shen111-6/ajf-01-adjustable-fixture/docs/design-report.md

# AJF-01：矩形工件可调定位夹具——设计项目报告

## 项目定位与完成边界
面向桌面尺寸检查、轻型装配时的矩形工件定位。已交付 SolidWorks 原生实体零件、29实例装配、28个有效锁定配合（另1个旧旋钮配合已抑制）、6张关联视图工程图，以及独立二维标注图、BOM和计算脚本。模型由AI辅助通过SolidWorks API生成，应由使用者打开、复核并完成亲自修改后，作为能解释的个人设计项目展示。尚无加工实物、重复定位实测、有限元结果或真实生产使用记录。模型里的锁定配合表示夹紧姿态，不是可拖动的运动模型。

## 需求与坐标
设计工件长度L=25～100mm、宽度W=20～80mm、高度H=10～20mm，质量不超过1kg；样例60×60×20mm。底板220×160×12mm。坐标X沿开口、Y沿夹爪、Z沿底板厚度；坐标原点为底板左下角底面。SW前视基准面对应XY，默认等轴测截图因此显得竖立，安装使用时底板水平。

## 方案与定位
选用“固定侧面+端挡块+滑动夹爪+手动推杆+双M8锁紧”，比较普通虎钳（现成但难体现自主结构选择）、T形槽压板（上方遮挡）、本方案（结构简单，方便展示定位面）。A为底板上表面，限制Z平移及绕X/Y转动；B为固定夹爪右侧面X=40，限制X平移及绕Z转动；C为端挡块后侧面Y=30，限制Y平移。这里是连续平面近似3-2-1定位思想，未设计六个离散定位点。推杆沿X作用于活动夹爪，工件靠紧B/C；两颗M8螺栓在槽中锁紧活动夹爪。向上拔出工件的约束只来自摩擦，不能按有正向Z夹紧能力使用，也不作为切削加工或吊装夹具。

## 结构与尺寸对应
固定夹爪置于(20,20,12)，其M6孔与底板(30,40)/(30,120)对齐。活动夹爪样例位置(100,20,12)，M8中心(110,40)/(110,120)。两条槽的端圆中心X=65/165，Y=40/120，宽9，总长109。端挡块置于(40,20,12)，M6中心(50,25)；其左面靠固定夹爪限制自身转动。支架置于(185,60,12)，M6中心(195,68)/(195,102)，M10孔轴线Y=85、Z=32。150mm推杆样例从X=120至270，旋钮覆盖丝杆末端12mm（X=258～270），形成连接啮合。底板下有15mm支脚，M8锁紧螺栓端部至Z=-11，距支承平面Z=-15尚有4mm名义间隙。

原95mm推杆不能覆盖小开口，已改为150mm全螺纹推杆。原方案20mm最小开口会让夹爪与端挡块仅零间隙，考虑公差后改为25mm最小开口；此时名义间隙5mm。25～100mm时活动夹爪M8中心X=L+50=75～150，距离槽中心端点分别至少10/15mm。推杆尾部与旋钮随开口变化，最大X约310mm；使用区域应留出伸出空间。两颗锁紧螺栓采用M8×65：54mm的上垫圈顶高减65mm杆长得到末端-11mm，避免长度选择不当碰桌面。

## 计算与敏感性
计算见calculations.csv/json及calculations.json及evidence记录。以T=KFd估算推杆轴向力，仅作为初步选型，未建立丝杆螺旋副与端面摩擦精确模型。推杆输入0.6N·m，K=0.15～0.25、d=10mm，轴向力约240～400N。取400N进行夹爪局部弯曲估算。将夹爪局部等效为宽20、厚20、高40mm悬臂，E假设206000MPa：I=13333.33mm⁴，σ=12MPa，δ≈0.00311mm。实际接触分布、孔洞、连接柔度、局部应力及螺栓力矩未包含，不能把这个数当整套夹具精度或有限元结果。

M8双锁紧的试验用估算扭矩6N·m，K=0.15～0.25，单颗预紧3000～5000N。取μ=0.1，最小抗滑600N，对400N载荷的理论裕量1.5。垫圈接触面积190.85mm²，最大平均承压约26.2MPa。M6双连接在3N·m时单颗预紧2000～3333N：取μ=0.15，最小抗滑600N、裕量1.5；若μ下降至0.1，裕量只有1.0。因此固定夹爪和支架的防滑是本版首要实测项目，油污、接触状态和扭矩系数变化会改变结论，不能据此宣称可靠承载。建议后续增加正向抗剪定位键/销，解决对摩擦的依赖。

M6×50穿过40mm夹爪后进入底板10mm。粗略取内螺纹有效剪切面积0.5π×5.35×10=84.04mm²、允许剪应力60MPa（假设），得到抗拔约5042N，对3333N的裕量约1.51。这不是标准螺纹失效认证；实际6061材料状态、攻丝质量和装配扭矩需确认，采用钢丝螺套是候选改进。全部扭矩为验证计划输入，未实测校准，不是生产装配规范。

## 图纸与工艺
CAD文件采用毫米、模型空间1:1，XY主视图配XZ/YZ视图；孔中心由坐标表定义，基准一致避免链式累积。外形±0.10、孔中心坐标±0.05是设计目标；槽宽9+0.2/0，基准A平面度0.05、夹爪接触面平面度0.03及对底面垂直度0.03为加工意图。孔的模型尺寸为螺纹底孔/通孔包络，M6和M10的完整螺纹、紧固件内六角与倒角未建模。原生SLDDRW提供模型关联视图；详细标注与制造说明在cad目录的二维图纸，二者一起使用。

底板：锯料→粗铣两面/四边→精铣A→按同一基准钻孔/铣槽→攻M6→去毛刺→测平面度。钢夹爪：正火料→粗铣→钻孔→精加工底面和接触面→检查垂直度。端挡块：铣削→钻孔→精加工接触面。支架：铣削→钻安装孔→横向钻8.5/攻M10，采用夹具保证孔轴线高度。支脚：车削/攻M6或采购。装配后靠实物调整B/C，不承诺拆装后恢复绝对位置；要稳定重复拆装定位，应增加定位销、匹配孔加工和测量方案。

## 误差分析
区分“名义位置误差”“重新装夹重复性”和“载荷变形”。M6通孔6.6对杆径6的名义单边间隙0.3mm，远大于0.03mm几何公差；因此仅标小公差不能保证固定夹爪相对底板绝对位置。重新装夹重复性取决于A/B/C表面、清洁度、工件形状、夹紧力和测量方法，理论悬臂挠度也不能替代重复定位测试。本版不宣称0.05mm或0.1mm重复定位能力。

## 验证与结果边界
文件与模型验证：原生文件和STEP已保存；重开后核查29个实例、28个MateLock、每个零件一个实体、参考路径、原生视图数量和模型包围盒；详细结果见evidence/native-validation.txt。解析和坐标检查见evidence/analytical-validation.json。25/60/100mm开口已分别建立实际静态装配；25mm和100mm使用边界尺寸工件。检查见range-validation.txt，三个装配均执行实体干涉检查，但没有建立可拖动运动仿真。全装配接触中允许存在螺纹包络干涉：M6杆径6与攻丝底孔5、M10杆径10与底孔8.5等；不宣称软件“零干涉”。已执行三种静态装配的实体干涉检查，每种各11处简化螺纹包络干涉，未发现其他实体穿透。

样机验证计划：见prototype-test-plan.md，重复装夹测X/Y各10次、检查固定夹爪/支架滑移、测量扭矩与推力、检查支脚及底部螺栓间隙；表格留空，不能填入虚构实测值。DFMEA示例见risk-review.csv，重点是夹爪滑移、螺纹损伤、夹持面划伤和误把轻型定位夹具用于切削。

## 简历与个人参与
你应先亲自打开原生文件、修改一个尺寸并更新图纸，熟悉定位约束、丝杆改长原因、锁紧力假设、公差和加工路线，再据实写AI辅助个人项目。未亲自完成的建模操作不能写“独立熟练完成”。可立即描述项目产物和你实际核对的部分，完成亲自复核后使用resume-and-interview.md里的项目版文案。不要写已实物验证、已投产、优化提升百分比、仿真通过或未经验证的精度。

## 发布版软件验收补充
旋钮由端面相接改为覆盖丝杆尾端12mm，当前样例X=258～270；25/100mm开口时尾端最远X=235/310。主装配的旧旋钮锁定配合已抑制，28个有效配合无错误。主装配与两端实际工件装配均有11处已分类螺纹包络干涉，没有其他实体穿透。三套装配经Pack and Go扁平整理，重开时29个引用均解析自发布目录。

以上是软件几何和文件完整性验收，不是载荷、重复定位或制造质量认证。局部悬臂公式不包含真实连接柔度、摩擦散差或偏心载荷相互作用；扭矩数值是未校准的试验输入。发布版本的承载与精度不作为已实测指标。
