shen111-6/ajf-01-adjustable-fixture/source/README.md

# SolidWorks API参考

这些C#文件是本项目实际软件检查、边界装配和Pack and Go的参考实现，需要Windows、SolidWorks 2024及其官方Interop程序集。不在GitHub托管Linux运行器上运行。

直接打开solidworks目录中的模型和图纸即可查看项目；不要把API参考代码当作无需SolidWorks的独立建模软件。
