shen111-6/ajf-01-adjustable-fixture/evidence/solidworks-base-drawing.png

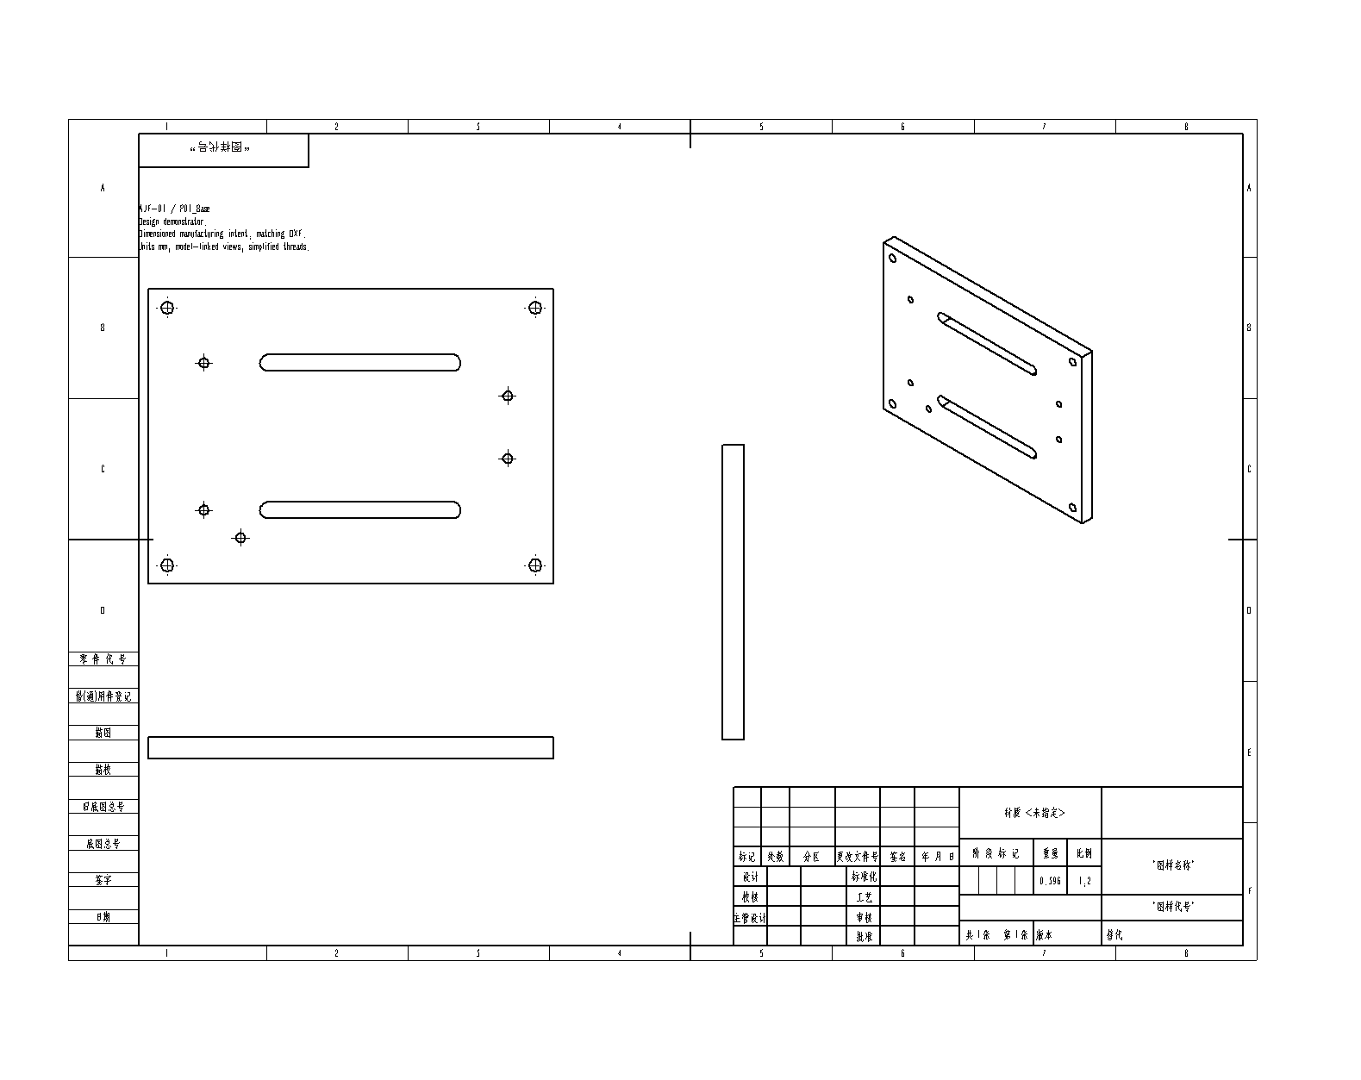
evidence/solidworks-base-drawing.png
