shen111-6/ajf-01-adjustable-fixture/evidence/solidworks-isometric.png

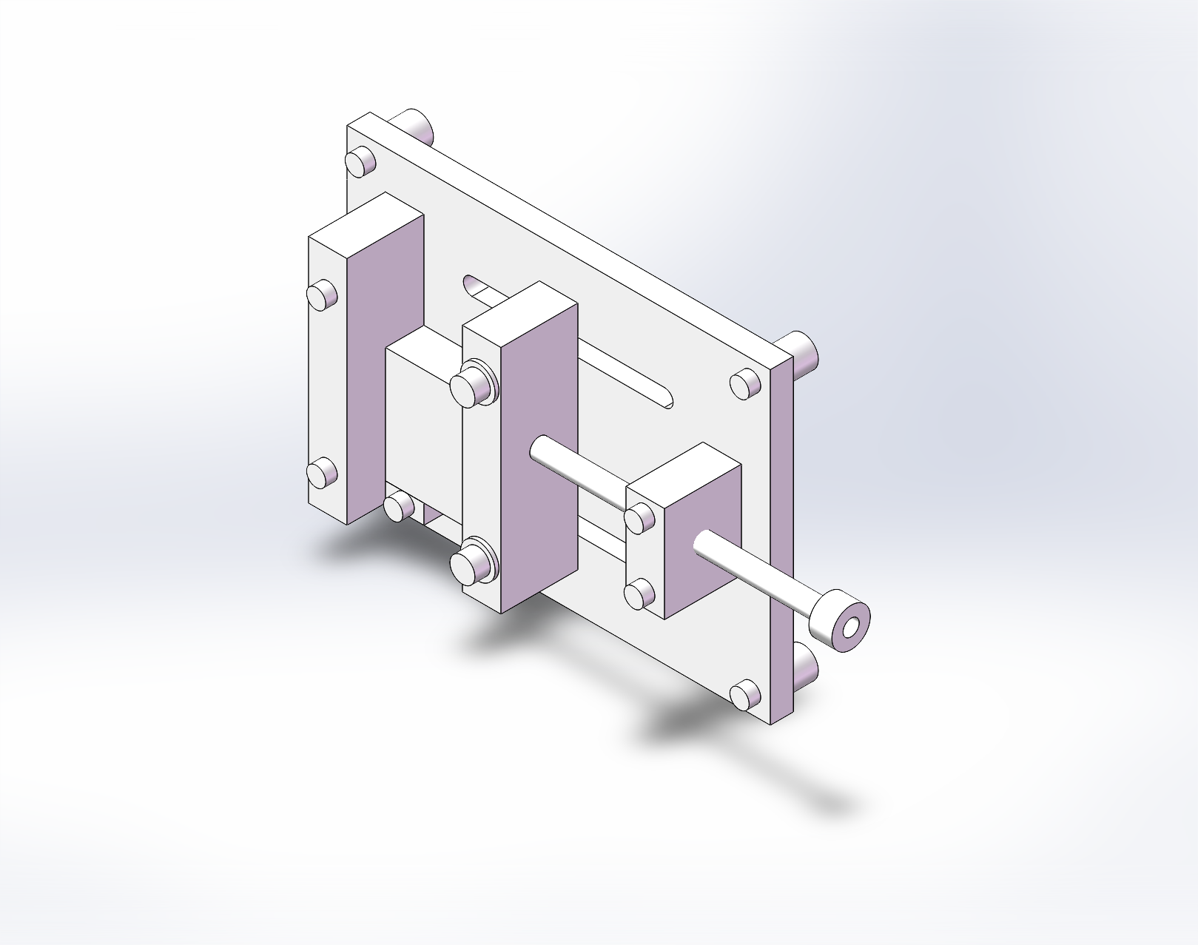
evidence/solidworks-isometric.png
