shen111-6/ajf-01-adjustable-fixture/evidence/component-transforms.txt

P02_FixedJaw-1|1,0,0,0,1,0,0,0,1,0.02,0.02,0.012,1,0,0,0
P01_Base-1|1,0,0,0,1,0,0,0,1,0,0,0,1,0,0,0
P08_Washer-3|1,0,0,0,1,0,0,0,1,0.11,0.12,0.052,1,0,0,0
P08_Washer-1|1,0,0,0,1,0,0,0,1,0.11,0.04,0.052,1,0,0,0
H04_M8Nut-2|1,0,0,0,1,0,0,0,1,0.11,0.12,-0.0085,1,0,0,0
P03_SlidingJaw-1|1,0,0,0,1,0,0,0,1,0.1,0.02,0.012,1,0,0,0
P05_ScrewBracket-1|1,0,0,0,1,0,0,0,1,0.185,0.06,0.012,1,0,0,0
P06_Spindle150-1|0,0,-1,0,1,0,1,0,0,0.12,0.085,0.032,1,0,0,0
P07_Workpiece-1|1,0,0,0,1,0,0,0,1,0.04,0.03,0.012,1,0,0,0
P08_Washer-2|1,0,0,0,1,0,0,0,1,0.11,0.04,-0.002,1,0,0,0
H04_M8Nut-1|1,0,0,0,1,0,0,0,1,0.11,0.04,-0.0085,1,0,0,0
P04_EndStop-1|1,0,0,0,1,0,0,0,1,0.04,0.02,0.012,1,0,0,0
H01_M8x65-1|1,0,0,0,1,0,0,0,1,0.11,0.04,-0.011,1,0,0,0
H02_M6x50-1|1,0,0,0,1,0,0,0,1,0.03,0.04,0.002,1,0,0,0
P08_Washer-4|1,0,0,0,1,0,0,0,1,0.11,0.12,-0.002,1,0,0,0
H01_M8x65-2|1,0,0,0,1,0,0,0,1,0.11,0.12,-0.011,1,0,0,0
H03_M6x25-4|1,0,0,0,1,0,0,0,1,0.21,0.01,-0.013,1,0,0,0
H03_M6x25-5|1,0,0,0,1,0,0,0,1,0.21,0.15,-0.013,1,0,0,0
H05_Foot-1|1,0,0,0,1,0,0,0,1,0.01,0.01,-0.015,1,0,0,0
H05_Foot-2|1,0,0,0,1,0,0,0,1,0.01,0.15,-0.015,1,0,0,0
H03_M6x25-3|1,0,0,0,1,0,0,0,1,0.01,0.15,-0.013,1,0,0,0
H02_M6x50-4|1,0,0,0,1,0,0,0,1,0.195,0.102,0.002,1,0,0,0
H02_M6x50-2|1,0,0,0,1,0,0,0,1,0.03,0.12,0.002,1,0,0,0
H03_M6x25-1|1,0,0,0,1,0,0,0,1,0.05,0.025,0.007,1,0,0,0
H05_Foot-3|1,0,0,0,1,0,0,0,1,0.21,0.01,-0.015,1,0,0,0
H02_M6x50-3|1,0,0,0,1,0,0,0,1,0.195,0.068,0.002,1,0,0,0
H03_M6x25-2|1,0,0,0,1,0,0,0,1,0.01,0.01,-0.013,1,0,0,0
H05_Foot-4|1,0,0,0,1,0,0,0,1,0.21,0.15,-0.015,1,0,0,0
H06_Knob-1|0,0,-1,0,1,0,1,0,0,0.258,0.085,0.032,1,0,0,0
