shen111-6/ajf-01-adjustable-fixture/docs/BOM.csv

编号 | 名称 | 材料/规格 | 尺寸mm | 数量 | 工艺/备注
P01 | 底板 | 6061-T6 | 220×160×12 | 1 | 铣削/钻孔/铣槽/攻M6
P02 | 固定夹爪 | 45钢 | 20×120×40 | 1 | 铣削/钻孔/精加工定位面
P03 | 活动夹爪 | 45钢 | 20×120×40 | 1 | 铣削/钻孔
P04 | 端挡块 | 45钢 | 20×10×20 | 1 | 铣削/钻孔
P05 | 丝杆支架 | 45钢 | 20×50×40 | 1 | 铣削/钻孔/攻M10
P06 | 全螺纹推杆 | 钢 | M10×1.5，杆长150 | 1 | 采购/截长/端面修整
P07 | 样例工件 | 铝 | 60×60×20 | 1 | 展示样例，不计夹具成本
P08 | 平垫圈 | 钢 | 内径9/外径18/厚2 | 4 | 采购
H01 | 锁紧螺栓 | 8.8级钢 | M8×65 | 2 | 采购；模型省略螺纹/内六角
H02 | 连接螺栓 | 8.8级钢 | M6×50 | 4 | 采购；模型省略螺纹/内六角
H03 | 短连接螺栓 | 8.8级钢 | M6×25 | 5 | 采购
H04 | 螺母 | 钢 | M8，对边13，厚6.5 | 2 | 采购
H05 | 支脚 | 钢 | 外径16，高15，M6通孔 | 4 | 采购或车削/攻丝
H06 | 手拧旋钮 | 钢/塑料 | M10连接，外径20，厚12 | 1 | 采购；需锁固至推杆，供应商确认
