shen111-6/ajf-01-adjustable-fixture/evidence/solid-interference.tsv

components | volume_mm3 | classification | possible
P05_ScrewBracket-1 + P06_Spindle150-1 | 435.895980686 | SIMPLIFIED_THREAD_ENVELOPE | False
H06_Knob-1 + P06_Spindle150-1 | 277.465463165 | SIMPLIFIED_THREAD_ENVELOPE | False
H03_M6x25-3 + H05_Foot-2 | 112.311937366 | SIMPLIFIED_THREAD_ENVELOPE | False
H03_M6x25-4 + H05_Foot-3 | 112.311937366 | SIMPLIFIED_THREAD_ENVELOPE | False
H03_M6x25-5 + H05_Foot-4 | 112.311937366 | SIMPLIFIED_THREAD_ENVELOPE | False
H03_M6x25-2 + H05_Foot-1 | 112.311937366 | SIMPLIFIED_THREAD_ENVELOPE | False
H02_M6x50-2 + P01_Base-1 | 86.3937979737 | SIMPLIFIED_THREAD_ENVELOPE | False
H02_M6x50-1 + P01_Base-1 | 86.3937979737 | SIMPLIFIED_THREAD_ENVELOPE | False
H02_M6x50-4 + P01_Base-1 | 86.3937979737 | SIMPLIFIED_THREAD_ENVELOPE | False
H02_M6x50-3 + P01_Base-1 | 86.3937979737 | SIMPLIFIED_THREAD_ENVELOPE | False
H03_M6x25-1 + P01_Base-1 | 43.1968989869 | SIMPLIFIED_THREAD_ENVELOPE | False
