shen111-6/ajf-01-adjustable-fixture/solidworks/AJF01_L100.STEP

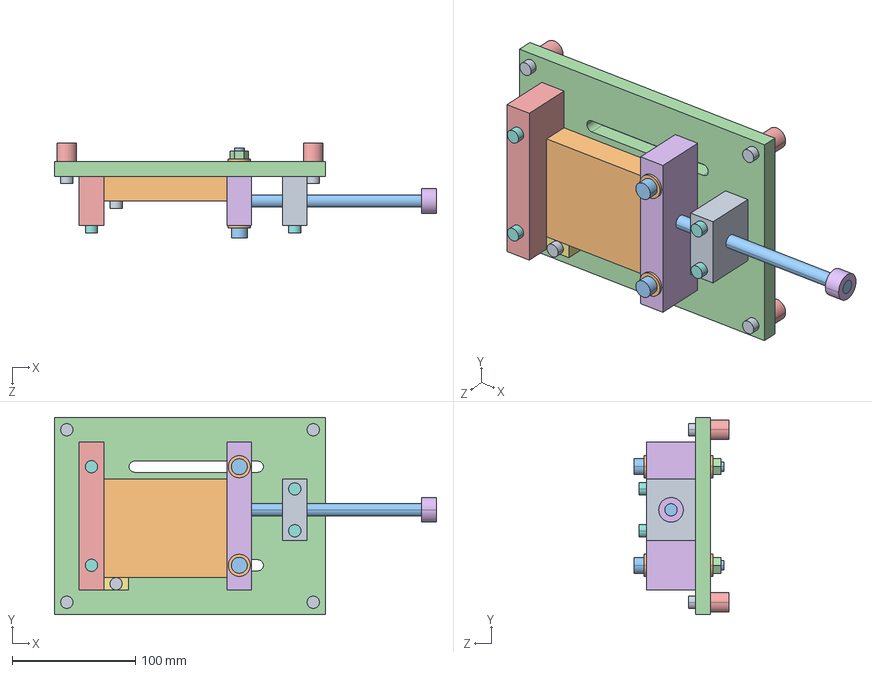
[picture p7: CAD file, 2026-10-12]
solidworks/AJF01_L100.STEP
310.0 x 160.0 x 77.0 mm
P05_ScrewBracket
Sample_100x80x20
P06_Spindle150
P01_Base
P02_FixedJaw
P03_SlidingJaw
P04_EndStop
H02_M6x50 x 4
H03_M6x25 x 5
P08_Washer x 4
H01_M8x65 x 2
H04_M8Nut x 2
H05_Foot x 4
H06_Knob
