shen111-6/ajf-01-adjustable-fixture/solidworks/H03_M6x25.STEP

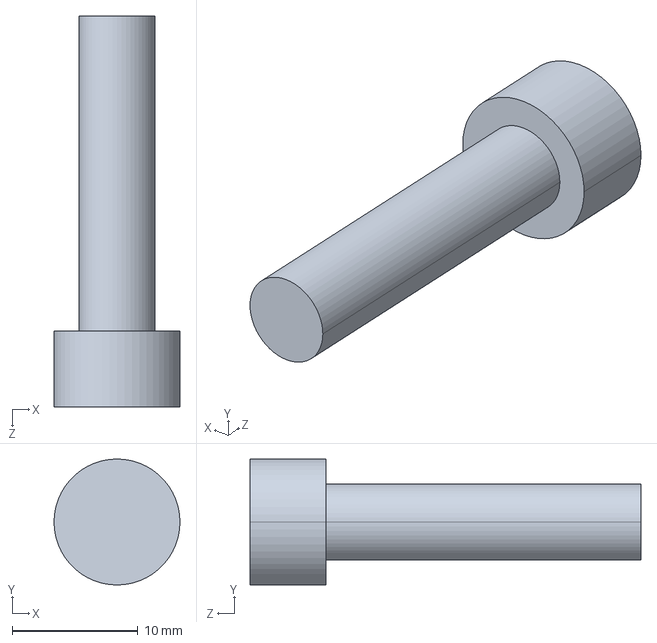
[picture p8: CAD file, 2026-10-12]
solidworks/H03_M6x25.STEP
10.0 x 10.0 x 31.0 mm
