shen111-6/ajf-01-adjustable-fixture/solidworks/P02_FixedJaw.STEP

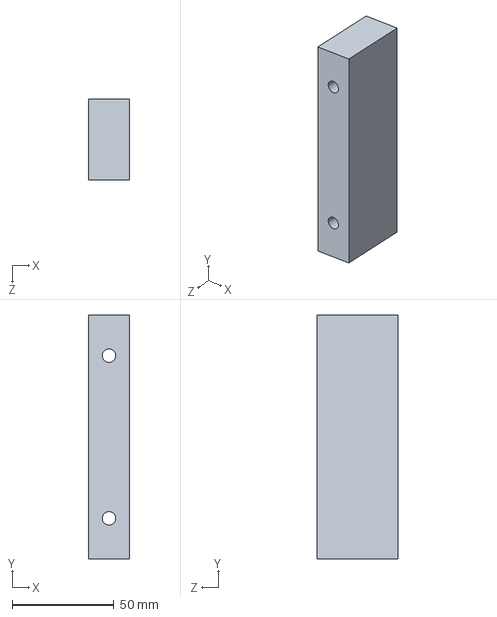
[picture p9: CAD file, 2026-10-12]
solidworks/P02_FixedJaw.STEP
20.0 x 120.0 x 40.0 mm
