shen111-6/ajf-01-adjustable-fixture/solidworks/H01_M8x65.STEP

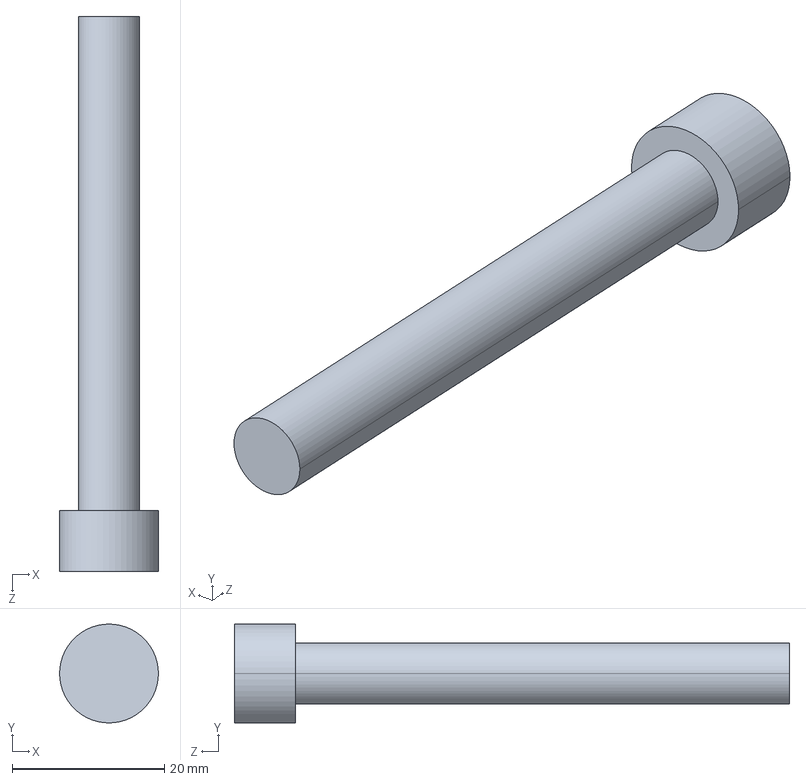
[picture p11: CAD file, 2026-10-12]
solidworks/H01_M8x65.STEP
13.0 x 13.0 x 73.0 mm
