shen111-6/ajf-01-adjustable-fixture/solidworks/P01_Base.STEP

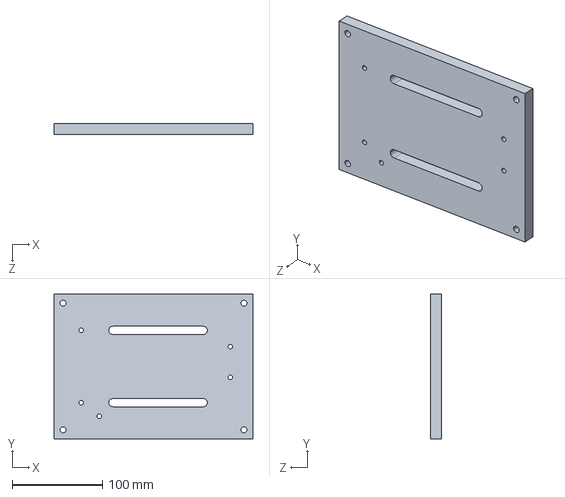
[picture p12: CAD file, 2026-10-12]
solidworks/P01_Base.STEP
220.0 x 160.0 x 12.0 mm
