shen111-6/ajf-01-adjustable-fixture/solidworks/H02_M6x50.STEP

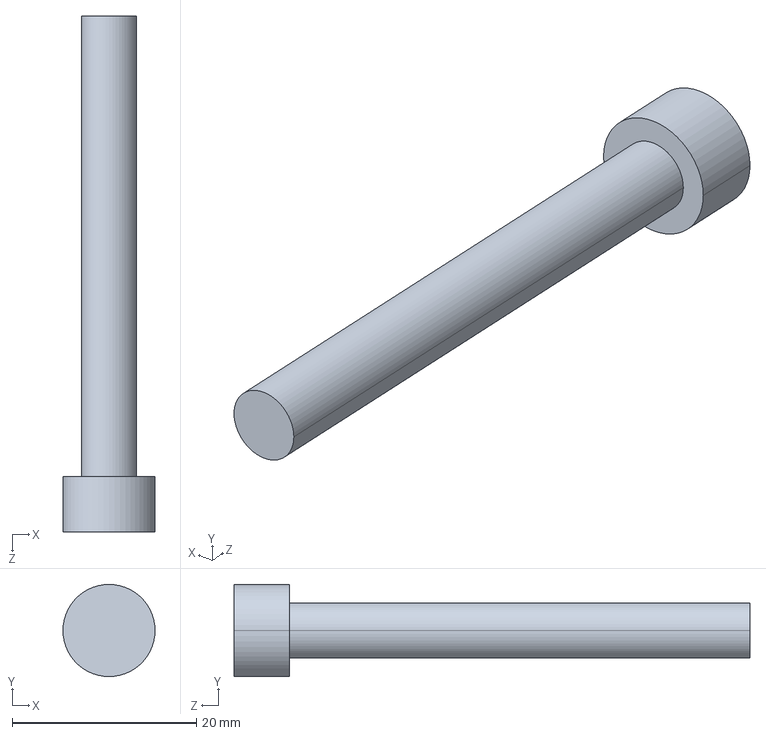
[picture p13: CAD file, 2026-10-12]
solidworks/H02_M6x50.STEP
10.0 x 10.0 x 56.0 mm
