shen111-6/ajf-01-adjustable-fixture/solidworks/Sample_25x20x10.SLDPRT

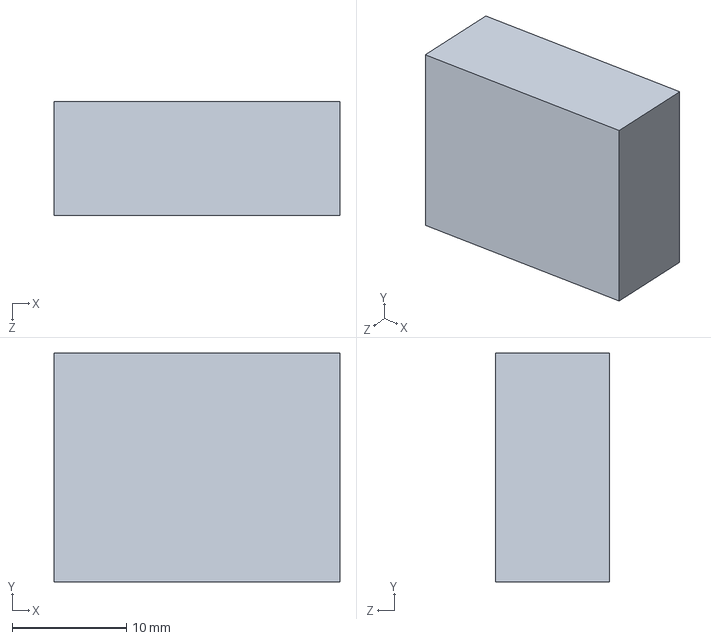
[picture p14: CAD file, 2026-10-12]
solidworks/Sample_25x20x10.SLDPRT
25.0 x 20.0 x 10.0 mm
