shen111-6/ajf-01-adjustable-fixture/solidworks/P07_Workpiece.STEP

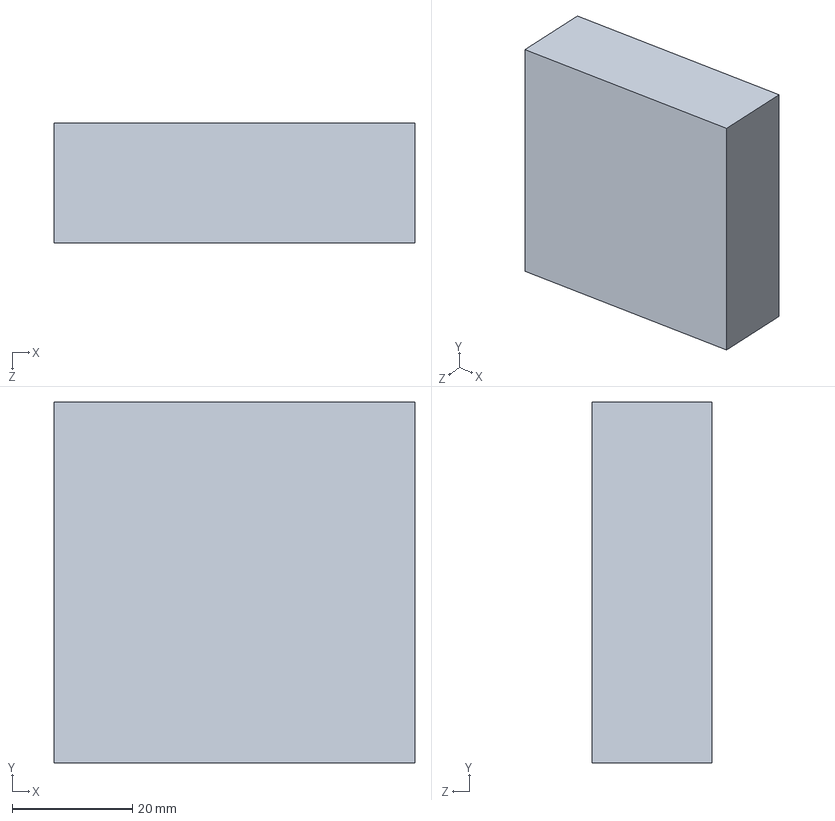
[picture p15: CAD file, 2026-10-12]
solidworks/P07_Workpiece.STEP
60.0 x 60.0 x 20.0 mm
