shen111-6/ajf-01-adjustable-fixture/solidworks/H06_Knob.STEP

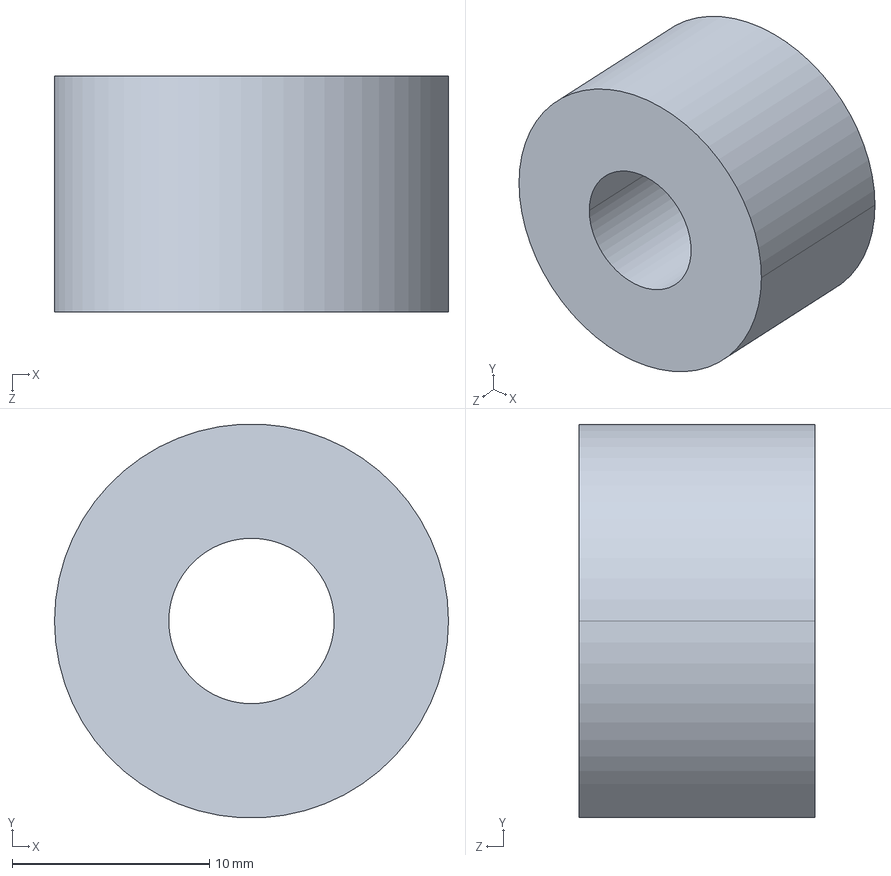
[picture p16: CAD file, 2026-10-12]
solidworks/H06_Knob.STEP
20.0 x 20.0 x 12.0 mm
