shen111-6/ajf-01-adjustable-fixture/solidworks/Sample_100x80x20.SLDPRT

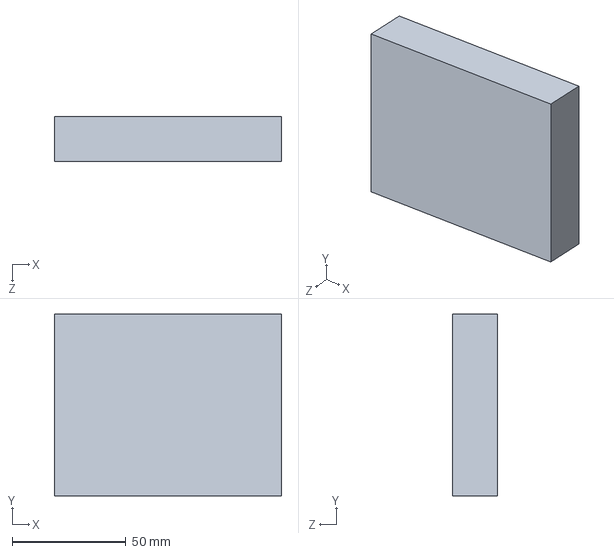
[picture p17: CAD file, 2026-10-12]
solidworks/Sample_100x80x20.SLDPRT
100.0 x 80.0 x 20.0 mm
