shen111-6/ajf-01-adjustable-fixture/solidworks/P06_Spindle150.STEP

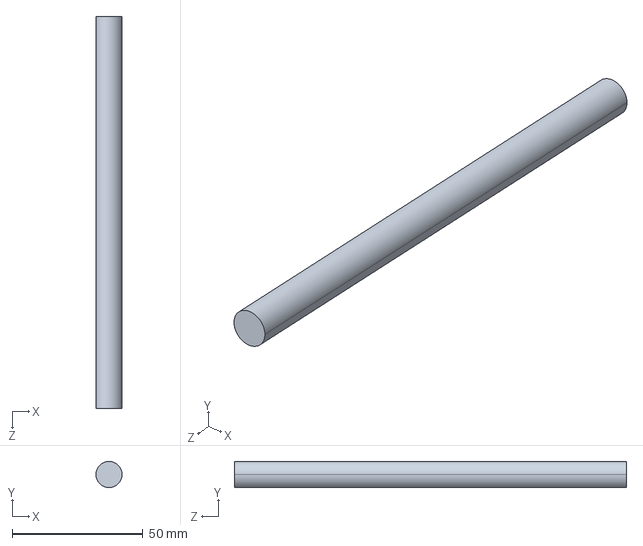
[picture p18: CAD file, 2026-10-12]
solidworks/P06_Spindle150.STEP
10.0 x 10.0 x 150.0 mm
