shen111-6/ajf-01-adjustable-fixture/solidworks/P04_EndStop.STEP

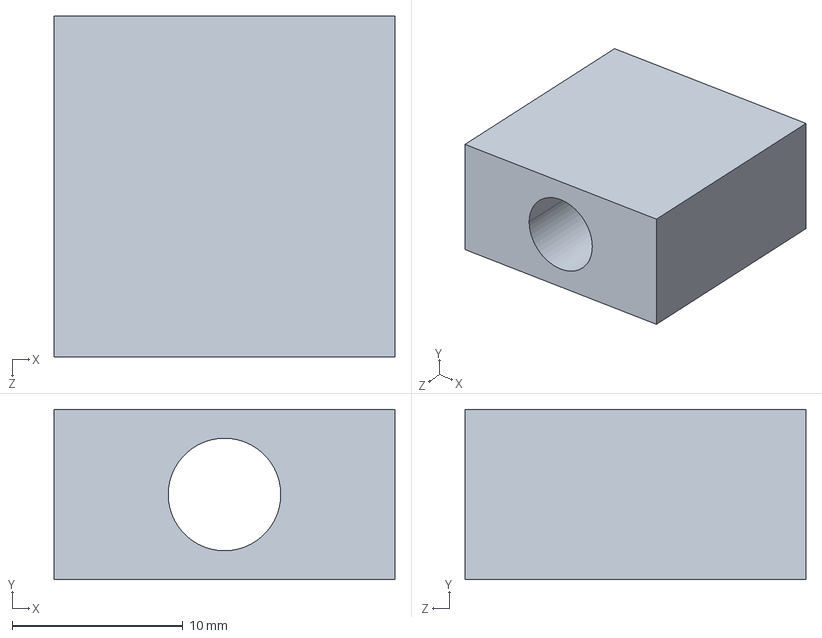
[picture p19: CAD file, 2026-10-12]
solidworks/P04_EndStop.STEP
20.0 x 10.0 x 20.0 mm
