shen111-6/ajf-01-adjustable-fixture/solidworks/H05_Foot.STEP

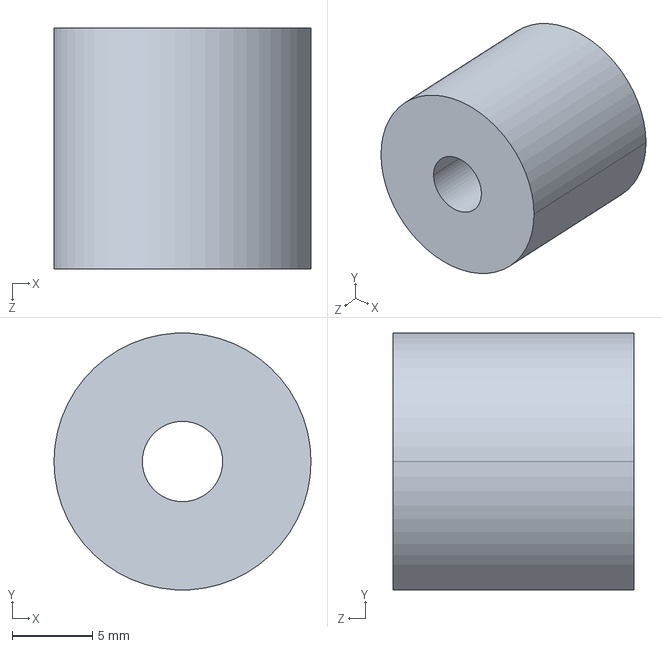
[picture p20: CAD file, 2026-10-12]
solidworks/H05_Foot.STEP
16.0 x 16.0 x 15.0 mm
