shen111-6/ajf-01-adjustable-fixture/solidworks/P05_ScrewBracket.STEP

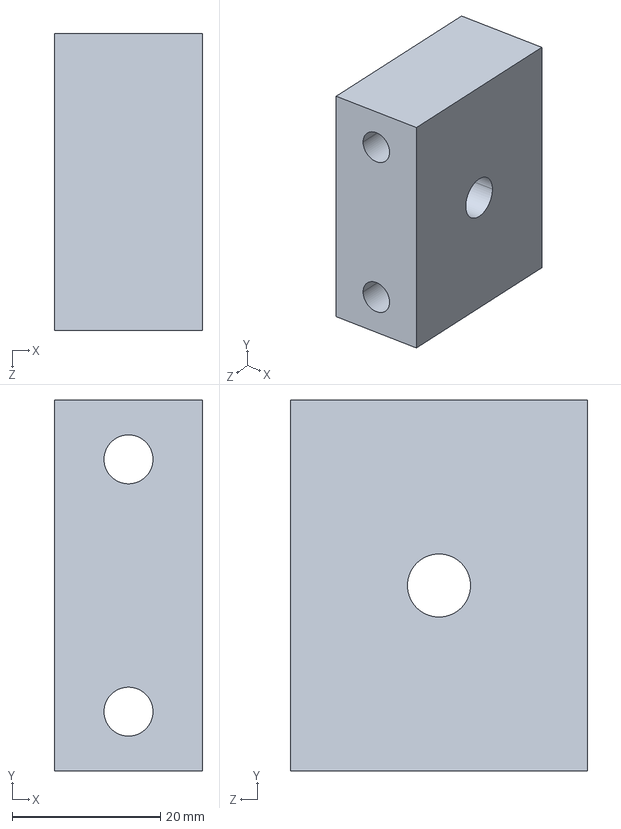
[picture p21: CAD file, 2026-10-12]
solidworks/P05_ScrewBracket.STEP
20.0 x 50.0 x 40.0 mm
