shen111-6/ajf-01-adjustable-fixture/(list of files, cad)

Other CAD files:
solidworks/P03_SlidingJaw.STEP
cad/AJF01_Assembly.dwg
cad/AJF01_Assembly.dxf
cad/P01_Base.dwg
cad/P01_Base.dxf
cad/P02_FixedJaw.dwg
cad/P02_FixedJaw.dxf
cad/P03_SlidingJaw.dwg
cad/P03_SlidingJaw.dxf
cad/P04_EndStop.dwg
cad/P04_EndStop.dxf
cad/P05_ScrewBracket.dwg
cad/P05_ScrewBracket.dxf
solidworks/AJF01_Assembly.SLDASM
solidworks/AJF01_Assembly.SLDDRW
solidworks/AJF01_L100.SLDASM
solidworks/AJF01_L25.SLDASM
solidworks/H01_M8x65.SLDPRT
solidworks/H02_M6x50.SLDPRT
solidworks/H03_M6x25.SLDPRT
solidworks/H04_M8Nut.SLDPRT
solidworks/H05_Foot.SLDPRT
solidworks/H06_Knob.SLDPRT
solidworks/P01_Base.SLDDRW
solidworks/P01_Base.SLDPRT
solidworks/P02_FixedJaw.SLDDRW
solidworks/P02_FixedJaw.SLDPRT
solidworks/P03_SlidingJaw.SLDDRW
solidworks/P03_SlidingJaw.SLDPRT
solidworks/P04_EndStop.SLDDRW
solidworks/P04_EndStop.SLDPRT
solidworks/P05_ScrewBracket.SLDDRW
solidworks/P05_ScrewBracket.SLDPRT
solidworks/P06_Spindle150.SLDPRT
solidworks/P07_Workpiece.SLDPRT
solidworks/P08_Washer.SLDPRT
solidworks/P08_Washer.STEP
