shen111-6/ajf-01-adjustable-fixture/evidence/native-validation.txt

SW=32.3.1
ASSEMBLY_REOPEN|components=29|openErrors=0|warnings=128
PART|P05_ScrewBracket.SLDPRT|bodies=1|box_m=0,0,0,0.02,0.05,0.04
PART|P07_Workpiece.SLDPRT|bodies=1|box_m=0,0,0,0.06,0.06,0.02
PART|P06_Spindle150.SLDPRT|bodies=1|box_m=-0.005,-0.005,0,0.005,0.005,0.15
PART|P01_Base.SLDPRT|bodies=1|box_m=0,0,0,0.22,0.16,0.012
PART|P02_FixedJaw.SLDPRT|bodies=1|box_m=0,0,0,0.02,0.12,0.04
PART|P03_SlidingJaw.SLDPRT|bodies=1|box_m=0,0,0,0.02,0.12,0.04
PART|P04_EndStop.SLDPRT|bodies=1|box_m=0,0,0,0.02,0.01,0.02
PART|H02_M6x50.SLDPRT|bodies=1|box_m=-0.005,-0.005,0,0.005,0.005,0.056
PART|H03_M6x25.SLDPRT|bodies=1|box_m=-0.005,-0.005,0,0.005,0.005,0.031
PART|P08_Washer.SLDPRT|bodies=1|box_m=-0.009,-0.009,0,0.009,0.009,0.002
PART|H01_M8x65.SLDPRT|bodies=1|box_m=-0.006500000000000001,-0.006500000000000001,0,0.006500000000000001,0.006500000000000001,0.07300000000000001
PART|H04_M8Nut.SLDPRT|bodies=1|box_m=-0.007505553499465135,-0.0065,0,0.007505553499465135,0.006500000000000001,0.0065
PART|H05_Foot.SLDPRT|bodies=1|box_m=-0.008,-0.008,0,0.008,0.008,0.015
PART|H06_Knob.SLDPRT|bodies=1|box_m=-0.01,-0.01,0,0.01,0.01,0.012
MATE|锁定1|error=0|warning=False|suppressed=False
MATE|锁定2|error=0|warning=False|suppressed=False
MATE|锁定3|error=0|warning=False|suppressed=False
MATE|锁定4|error=0|warning=False|suppressed=False
MATE|锁定5|error=0|warning=False|suppressed=False
MATE|锁定6|error=0|warning=False|suppressed=False
MATE|锁定7|error=0|warning=False|suppressed=False
MATE|锁定8|error=0|warning=False|suppressed=False
MATE|锁定9|error=0|warning=False|suppressed=False
MATE|锁定10|error=0|warning=False|suppressed=False
MATE|锁定11|error=0|warning=False|suppressed=False
MATE|锁定12|error=0|warning=False|suppressed=False
MATE|锁定13|error=0|warning=False|suppressed=False
MATE|锁定14|error=0|warning=False|suppressed=False
MATE|锁定15|error=0|warning=False|suppressed=False
MATE|锁定16|error=0|warning=False|suppressed=False
MATE|锁定17|error=0|warning=False|suppressed=False
MATE|锁定18|error=0|warning=False|suppressed=False
MATE|锁定19|error=0|warning=False|suppressed=False
MATE|锁定20|error=0|warning=False|suppressed=False
MATE|锁定21|error=0|warning=False|suppressed=False
MATE|锁定22|error=0|warning=False|suppressed=False
MATE|锁定23|error=0|warning=False|suppressed=False
MATE|锁定24|error=0|warning=False|suppressed=False
MATE|锁定25|error=0|warning=False|suppressed=False
MATE|Legacy_Knob_Lock_Suppressed|error=0|warning=False|suppressed=True
MATE|锁定27|error=0|warning=False|suppressed=False
MATE|锁定28|error=0|warning=False|suppressed=False
MATE|锁定29|error=0|warning=False|suppressed=False
MATES|lockCount=28|featureErrors=0
DRAWING_REOPEN|AJF01_Assembly.SLDDRW|modelViews=4|referencesExist=PASS
DRAWING_REOPEN|P01_Base.SLDDRW|modelViews=4|referencesExist=PASS
DRAWING_REOPEN|P02_FixedJaw.SLDDRW|modelViews=4|referencesExist=PASS
DRAWING_REOPEN|P03_SlidingJaw.SLDDRW|modelViews=4|referencesExist=PASS
DRAWING_REOPEN|P04_EndStop.SLDDRW|modelViews=4|referencesExist=PASS
DRAWING_REOPEN|P05_ScrewBracket.SLDDRW|modelViews=4|referencesExist=PASS
RESULT|PASS|uniquePartTypes=14|samples=1|motionSimulation=NOT_RUN|FEA=NOT_RUN|physicalTest=NOT_RUN|fullSolidInterference=NOT_RUN
