shen111-6/ajf-01-adjustable-fixture/CHANGELOG.md

# 修订记录

## v1.0.0 · 设计与软件验证交付
- 150mm全螺纹推杆，25～100mm设计开口。
- 修正旋钮末端12mm啮合，保留旧锁定配合为抑制历史。
- 建立三个实际静态装配，每套29实例；主装配28个有效配合无错误。
- 三套装配实体检查各11处已分类螺纹包络重叠，无其他实体穿透。
- 六张DWG与关联图纸，BOM、计算、工艺与风险记录。
- Pack and Go及交付目录重开检查，作品集首页和版本下载。

早期95mm丝杆、20mm最小开口和端面相接旋钮属于已废弃草案，不在本次发布模型中。
