shen111-6/ajf-01-adjustable-fixture/docs/risk-review.csv

失效模式 | 原因 | 影响 | 设计措施 | 验证/改进
活动夹爪滑移 | 预紧不足或低摩擦 | 工件偏移 | 双M8及垫圈；敏感性计算 | 实测推力/抗滑；考虑定位键
固定夹爪/支架滑移 | M6连接依赖摩擦 | 失去定位 | 明确摩擦假设和扭矩估算 | 加销/键，测位移
铝底板螺纹损伤 | 攻丝缺陷/过大预紧 | 连接松动 | 10mm有效啮合；初算抗拔 | 试装；候选钢丝螺套
推杆尾端空间不足 | 全螺纹加长 | 操作干涉 | 记录最大310mm包络 | 桌面安装布局检查
工件表面划伤 | 钢面对铝工件 | 外观损伤 | 控制夹紧力；预留软垫改进 | 检查接触面；软垫需重算基准
误用为加工夹具 | 工况未限定 | 滑移/脱落 | 明确用于桌面定位 | 不得宣称切削能力
